schubbydoo/LED-Light-Bar/README.md

# LED Light Bar

A portable, battery-powered light bar whose ambience is driven by speech, so that a simulated
fire appears to speak the words of a greeting.

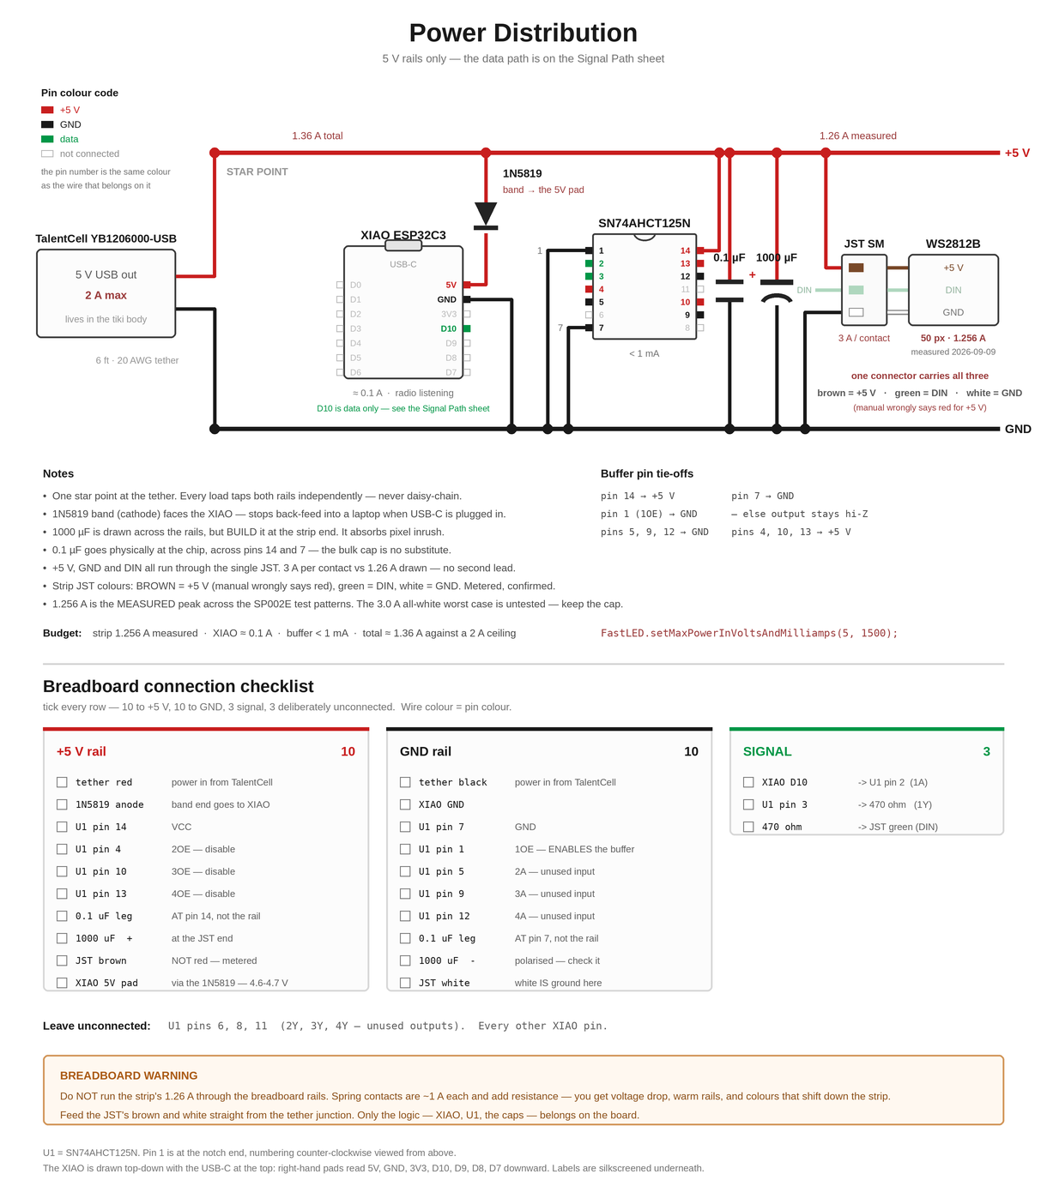
[picture p1: images/power-distribution.png]
Power distribution


## What it is

A ~1 m (3.2 ft) strip of **144** addressable pixels in a flexible diffuser, run by a XIAO
ESP32C3 on a battery. (It ran as a 14" section of 50 pixels in a rigid channel until 2026-09-12;
the count is the only thing that changed about the effect, and `docs/02-build-and-power.md`
carries what it did to the power budget.) **The length is a setting** — `len <inches>`, 1 to 144
— because the flexible diffuser contours to whatever prop the bar visits, so how much of the
strip is in use is a fact about the season rather than about the build. It renders a **named ambience** — `fire`, `water`, `storm` — continuously and
unsupervised. When the [SFX Box](#the-sfx-box) plays a greeting, the speech modulates that
ambience in time with the words.

For Halloween 2026 it is placed in the mouth of a borrowed tiki: firelight on the back of the
throat, and when a visitor triggers the prop, the fire speaks to them.

## Design in brief

**The box owns the speech; the bar owns the aesthetics.** The SFX Box sends an ambience name,
a pre-computed speech track, a cue at actual playback start, and a position update every couple
of seconds. It never sends colours. The bar excites its ambience with two scalars —
`excitation` and `onset` — which each ambience interprets in its own visual terms.

That separation is what makes the capability generic: the same two numbers drive a servo jaw on
another prop. See `sfx-box/spec-addendum-5.7A-speech-driven-channels.md`.

## Documentation

| | |
|---|---|
| [`docs/01-effect-design.md`](docs/01-effect-design.md) | The fire model, speech modulation, and the failure modes that make an LED strip look like an LED strip |
| [`docs/02-build-and-power.md`](docs/02-build-and-power.md) | Electrical ground truth — power, signal, both diagrams, strip specs, mechanical constraints |
| [`docs/03-perfboard-layout.md`](docs/03-perfboard-layout.md) | The electronics pod: layout rules, wiring list, staged assembly and test order |
| [`docs/04-rf-link.md`](docs/04-rf-link.md) | ESP-NOW: why not WiFi or 433, the SFX Box bridge wiring, and what crosses the link |
| [`docs/05-parts.md`](docs/05-parts.md) | What was bought and why |
| [`docs/archive/`](docs/archive/) | Superseded work, kept because the reasoning is still useful |

## Status

**Hardware verified and wired. Firmware not started.**

The strip was smoke-tested on its bundled SP002E controller: all 50 pixels light, and the power
path through the single JST is proven at **1.256 A measured**. Wire colours were metered to the
silkscreened pads, and the light-bar wiring was completed 2026-09-09.

That measurement was the 50-pixel run. Since **2026-09-12** the build lights all 144, and an
averaged USB meter reads **~1.0–1.2 A (~5.5 W)** with the fire at rest — about **55 %** of the
TalentCell's 2 A ceiling and **~9 h** of runtime. **During a greeting it drops to ~0.7–0.8 A**,
because the speech effect blacks the strip out between words, so a busy night costs less than a
quiet one. `./send.sh bar pwr` reports the firmware's own estimate, which agrees with the meter —
read the meter over time, since a breathing fire makes any single sample meaningless.

*This Status section otherwise predates the firmware, which is written and running on the prop —
`CLAUDE.md` is the current account.*

Nothing downstream of the XIAO's data pin has been exercised yet, since no code exists. Next
step is firmware — start from `docs/01-effect-design.md`, and make the first thing that runs a
single-pixel test rather than the fire renderer.

## The SFX Box

A separate, private project: a general-purpose Raspberry Pi effects controller that plays the
audio, watches the sensor, and drives this bar. It is **not vendored here**. `sfx-box/` contains
only the architectural proposal that project needs in order to host this capability.

## Licence

Personal project. No licence granted.
