schubbydoo/LED-Light-Bar/images/power-distribution-hand-drawn.png

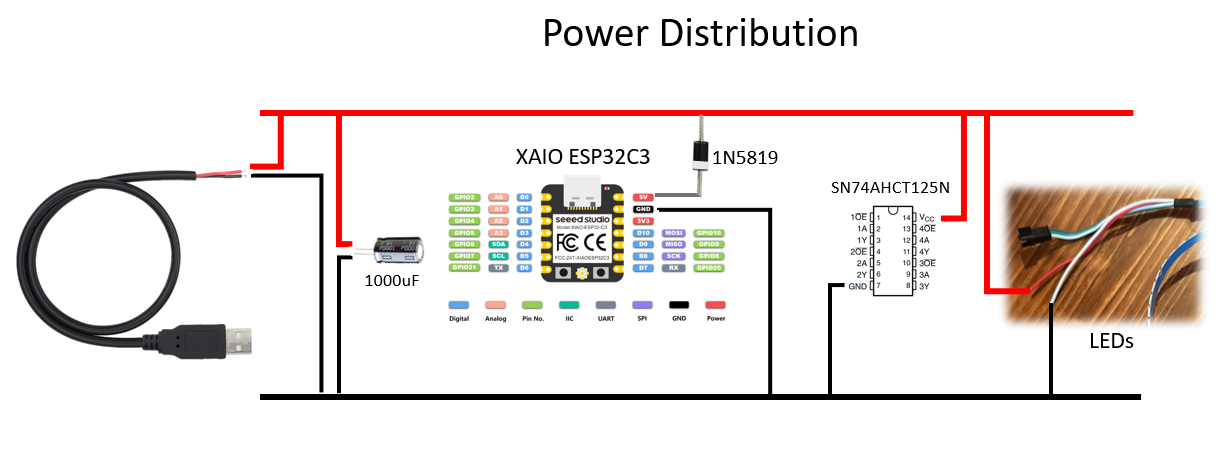
images/power-distribution-hand-drawn.png
