schubbydoo/LED-Light-Bar/images/parts/433-tx118sa-rx480e.jpeg

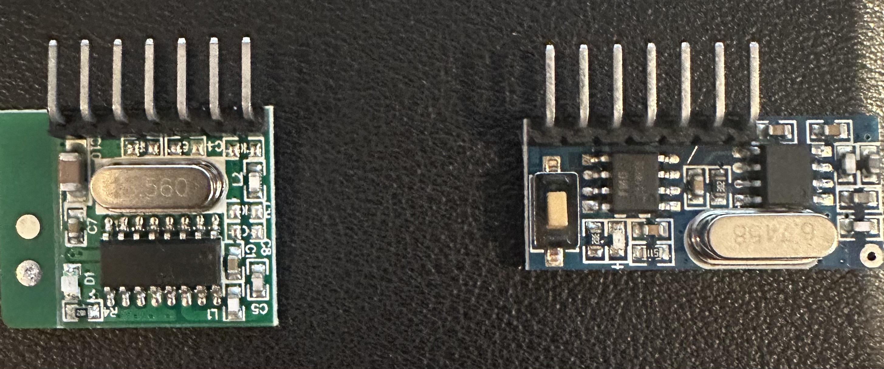
images/parts/433-tx118sa-rx480e.jpeg
