schubbydoo/LED-Light-Bar/images/parts/xiao-esp32c3.jpeg

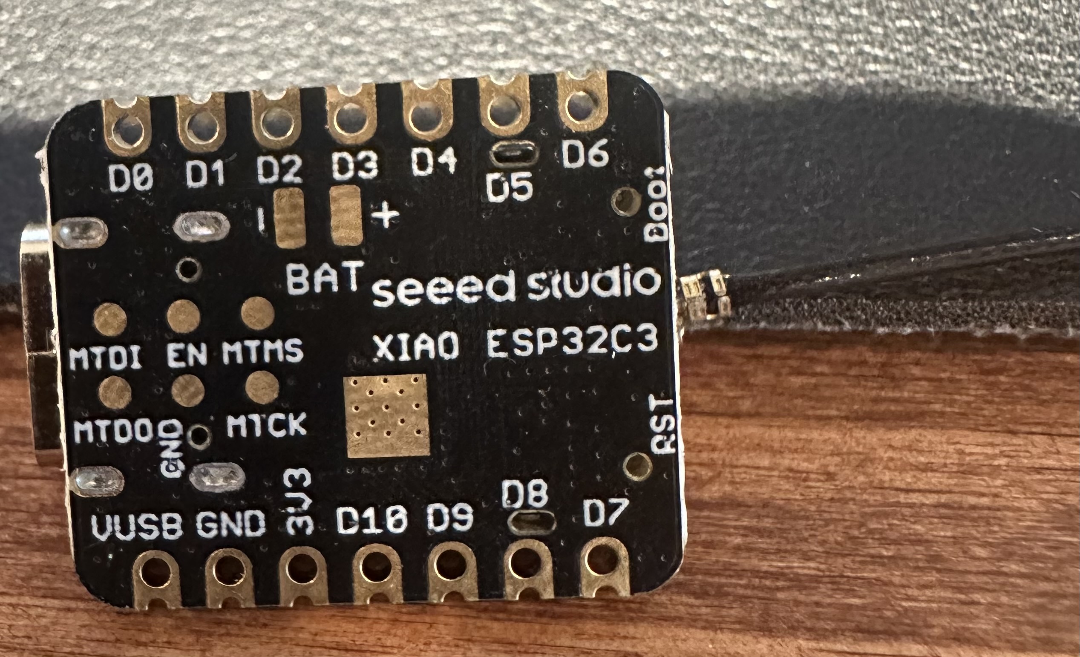
images/parts/xiao-esp32c3.jpeg
