schubbydoo/LED-Light-Bar/(commit log)

2026-09-09 Initial commit: LED Light Bar design, wiring and SFX Box addendum
    Speech-driven light bar: 50 WS2812B pixels on a XIAO ESP32C3, battery
    powered, driven over ESP-NOW by the SFX Box so a simulated fire appears
    to speak the words of a greeting.
    Hardware is verified (SP002E smoke test, 1.256 A measured) and the
    light-bar wiring is complete. No firmware exists yet.
    Contents:
    - docs/01..05 - effect design, power and signal, perfboard layout,
    the ESP-NOW link, and parts
    - images/ - power distribution, signal path and SFX Box bridge sheets;
    every pin colour-coded by function, XIAO drawn as a top view
    - sfx-box/ - the 5.7A spec addendum the SFX Box project needs; the
    SFX Box repo itself is de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
2026-09-10 Say what the box provides, and where the firmware lives
    Two things settled with the SFX Box side today.
    The box now generates and serves word timestamps — GET /media/timestamps/<id>,
    one shape whichever provider answered, with a version field for a bar that
    cached a track. That is the discrete half of the two-axis model, not the fire's
    driver: word boundaries make a fire strobe rather than burn, and the envelope
    this project actually wants is still unbuilt on that side. What timestamps give
    us is the other half the addendum asks for — phrase structure, so the bar can
    visibly settle between phrases and flare harder on an emphasised word.
    Three entry types occur in a real track, checked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
2026-09-10 Firmware bring-up: prove the chain before the strip is at risk
    No code had ever run on this board. The strip was smoke-tested on its bundled
    SP002E controller, so the pixels and the power path are known good — what has
    never been exercised is our own signal path: D10, the AHCT125, the 470R, the JST.
    Two sketches, in the order the risk demands.
    `metercheck` runs with the strip disconnected. It holds D10 at steady DC long
    enough to read with an ordinary multimeter — a meter cannot follow a 400 ns
    WS2812 bit, and averaging a data stream gives a meaningless number between the
    rails. Probe U1 pin 2 and pin 3: pin 3 at ~5 V while pin 2 sits at 3.3 V proves
    the entire level-shifter stage in o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
2026-09-10 The diode is a 1N5819 — say so once, everywhere
    The build offered either a 1N5817 or a 1N5819 and then two documents each picked
    a different one. `docs/03` named the 5817 in its parts table, its zone map and
    both rows of its wiring list; the diagrams and the checklist named the 5819.
    The board has a 5819. Confirmed against the part, 2026-09-10.
    No number changes, which is why this went unnoticed: every figure in the repo
    already assumed the 5819's higher drop. The XIAO's 5 V pad is documented as
    4.6-4.7 V rather than 5.0, and that reading is how you confirm the diode is
    oriented correctly rather than a sign of a sagging rail.
    Found while reviewing the sheets before the strip was connect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
2026-09-10 The fire: four layers, one expression, no talking mode
    `bar/` implements docs/01's model — ember floor, whole-strip breath, correlated
    spatial noise, Poisson flares — with colour a pure function of heat and gamma
    applied last. 458 kB, 34 % of flash.
    The structural decision is the whole design:
    heat[i] = clamp(EMBER_FLOOR,
    (noise[i] + flare[i]) * breath * (1 + speechGain*env),
    1.0)
    At env == 0 that collapses exactly to the idle fire. So there is no talking
    mode, no crossfade, and no state to get wrong — idle is speech with a zero
    envelope. Written this way on purpose: a prop that switches to a "speaking"
    animation stops being a fire that sp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
    [bar.ino, pixelcheck.ino]
2026-09-10 Fire palette: orange body, amber sparks, and a live warmth knob
    Two rounds of feedback against a real strip. First pass came out red, second
    came out yellow; this is the middle, and it is not signed off — it was judged
    against a white wall, which docs/01 §2 names as the surface that will mislead
    you. Recorded so the numbers are not lost, not because they are final.
    The red one had a mechanical cause worth keeping. Per-channel gamma on a palette
    authored as PWM values crushes it:
    (200, 50, 0) "orange" --gamma 2.2--> (149, 7, 0) near-pure red
    (255,110,10) "flame" --gamma 2.2--> (255, 40, 0) deep red-orange
    (255,190,80) "tip" --gamma 2.2--> (255,133,20) merely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
2026-09-10 The link: text over ESP-NOW, and the bar answers back
    The bridge forwards serial lines verbatim and the bar feeds them into the SAME
    parser its own serial port uses, so every command it already understood worked
    over the radio the moment this existed. No second protocol, no second parser to
    drift. Proven end to end:
    ./send.sh bridge "set yellow 0.75"
    ./send.sh bridge "set brightness 90"
    ./send.sh bridge st
    bar> st amb=fire y=0.75 br=90 breath=1.10 rel=0.080 gain=1.20 env=0.00
    Text rather than a binary struct at this stage: the wire is readable, so a
    mismatch between the ends is visible instead of a silent misalignment, and the
    link can be exercised by hand before anythin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
    [bar.ino, bridge.ino]
2026-09-10 The fire speaks: resident track, and a clock that is not ours
    bar> cue ok 1 at 13000 lead -40
    env=0.92 trk=2067 playing@19160
    env=0.77 trk=2067 playing@25206
    env=0.48 trk=2067 playing@32222
    The Tiki greeting's envelope, generated on the Pi, pushed over ESP-NOW, and
    stepped against the box's clock.
    The track is RESIDENT before playback starts and is never streamed. 2 bytes per
    frame at 50 Hz is 100 B/s, so 41 s is 4.1 kB — 28 chunks in one burst at
    provisioning time. During the performance the link carries a cue, a position
    update every couple of seconds, and nothing else, which means packet loss during
    a greeting is not a failure mode that exists.
    THE CLOCK IS THE BOX'S.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
    [bar.ino, bridge.ino]
2026-09-10 Words, not loudness — and a fire that was rendering in a third of its range
    audio bar drift env
    2.83 2.87 +48ms 0.00 drums: fire idle
    10.76 10.78 +21ms 0.00
    14.76 14.73 -22ms 0.26 first word at 13.6s
    18.71 18.75 +40ms 1.00 mid-word
    22.64 22.67 +33ms 0.29 between words
    38.51 38.50 -11ms 1.00
    Sync holds to +/-55ms across 40 seconds with no accumulation — the errors wander
    around zero rather than growing, which is the cue carrying real playback position
    plus `pos` easing it. Spec success criterion is ~50ms; met on the first measured
    run.
    THE IDLE FIRE WAS BROKEN, and it was underneath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
    [bar.ino, bridge.ino]
2026-09-10 The approved effect: red words over a breathing fire
    Signed off on the prop. Compiled defaults are now the values that were actually
    judged, not the ones I guessed:
    flashHue 0 red
    flash 0.6 the flame shows THROUGH the speech colour
    blackout 0.6 fire dims to 40% between words, not fully out
    0.6 rather than 0.9 on the mix because at 0.9 the speech colour nearly replaces
    the fire and reads as a separate light switching on. At 0.6 the bright parts of
    the flame come through warmer than the dim parts, so the strip keeps its own life
    while a word is lit — "the fire goes red", not "a red light turns on".
    0.6 rather than 1.0 on the blackout because full darkness left th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
    [bar.ino]
2026-09-11 The fire stops teleporting: accumulate the noise phase
    A noise coordinate must be an ACCUMULATED PHASE, never `time * rate`.
    This read:
    uint16_t tz = (uint16_t)(tSec * P.timeScale * (1.0f + 0.6f * env));
    which multiplies ABSOLUTE time by a rate that speech is modulating. The
    instant `env` moves, the product jumps — thirty seconds in, env going
    0.4 to 0.9 shifts tz by over a THOUSAND noise units. The pattern does not
    speed up, it teleports. Against a real speech envelope moving several
    times a second the whole strip scrubs back and forth, and what you see is
    rapid blinking. `noisePhase += dt * timeScale` is the whole fix, and
    speech now genuinely accelerates the drift with no disconti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
    [bar.ino]
2026-09-11 The track survives a power cycle
    This stopped being a field-reliability nicety today and became the thing
    that actively broke a day of testing: the track lived only in RAM, so
    every firmware reflash emptied it, and three consecutive greetings played
    to a silently dark bar while looking exactly like the effect being broken.
    In the field a battery blip would do the same, mid-evening, with nobody
    able to explain it.
    Two stores, because the two kinds of state want opposite things.
    PARAMS -> NVS, and only on an explicit `save`. Auto-saving on every `set`
    would write flash on every nudge of a tuning slider, and tuning is dozens
    of nudges. Explicit also matches how a look is actually arrived at: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
    [bar.ino]
2026-09-11 Write down how persistence works, and what it changed about verification
    The commit that built it landed without the doc update — the anchor I
    patched against did not exist. Content is the same: two stores with
    opposite needs, params as a versioned-and-sized blob rather than a key per
    parameter, and why `st` had to start reporting the clip the moment a
    track could outlive a reboot.
2026-09-11 A lamp: a chosen colour, solid or blinking or breathing
    A prop does not always want speech. Sometimes it wants a red light that
    comes on, or a blue one that breathes.
    That is not a second renderer, and it must not become one. A LAMP IS AN
    AMBIENCE WHOSE PALETTE RAMPS FROM BLACK TO A CHOSEN COLOUR, so at heat 0
    it is off and at heat 1 it is the colour — which means "solid" and
    "breathing" fall straight out of the layers that already exist and only
    blinking is new. `motion` decides what feeds heat and nothing after that
    changes: a lamp goes through the same palette lookup, the same speech
    excitation, the same word colour and the same blackout as a fire does. A
    blinking red lamp that also sp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
2026-09-11 Hold the top of the palette instead of wrapping to black
    `ColorFromPalette` with LINEARBLEND treats a 16-entry palette as a RING:
    at index 255 it blends entry 15 back toward entry 0 and returns 15/16 of
    entry 0 — which in every palette here is BLACK. Heat clamps to 1.0, so
    heat 1.0 rendered as almost nothing.
    Found because `motion solid` pins heat at exactly 1.0, and the strip went
    dark: reported as "the light bar is not on anymore". The battery had also
    died, which explains the strip being unlit — but the XIAO runs off the
    box's USB and kept answering, and it reported `heat=1.00 px=62,10,2`. That
    is arithmetic, not a power symptom.
    The fire had the same fault, silently. Peak heat happ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
2026-09-12 The whole strip, and a length you can set
    Two changes that only make sense together. The bar now lights all 144 pixels
    of the metre rather than a 14" cut of 50 — and because the new diffuser is
    flexible rather than a rigid channel, how much of that metre is in use became
    a property of the season instead of the build.
    NUM_LEDS is gone. MAX_LEDS (144) sizes the buffers and is the only part that
    is still a recompile; P.numLeds is live, persisted and settable over the
    radio as `set leds <n>` or `len <inches>`. The tail beyond it is written black
    every frame, not once, because FastLED clocks the whole buffer either way and
    a tail painted once would freeze the last image on it. The FastLED cont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
2026-09-12 Measured, not calculated: the cap does not bite and the draw is half what we said
    Flashed the 144-pixel build to the bar and then asked it what it actually
    draws. Both answers contradict the arithmetic committed this morning.
    A USB meter on the supply reads 5.05 V / ~0.80 A — about 4 W for the whole
    build, XIAO included, against a predicted ~1.5 A. The prediction came from the
    manual's 0.12 W/LED scaled by brightness, and that is the figure for WHITE.
    This fire is amber and red at partial heat and never goes white, so the real
    number is a little over half of it. Runtime follows: ~13 h, not ~6.5 h, so the
    "margin is one night rather than two" warning was pessimistic by 2x.
    The cap therefo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
2026-09-12 A length of zero is a typo, not a request
    The bar went dark except for pixel 0 showing amber, on a prop that had been
    working. That is not a failure mode — it is the renderer doing exactly as it
    was told with numLeds=1: the fire renders into pixel 0 and the tail blackout
    takes the other 143.
    Arduino's String::toFloat() answers 0.0 for anything it cannot parse. So
    `len abc`, `len` with a stray character, `set leds 0` and `set leds` with junk
    all arrive as zero, and the clamp I wrote turned every one of them into one
    pixel. A typo wearing the costume of a dead strip is the worst possible
    disguise: it sends you to the wiring, the power rail and the level shifter
    before it occurs to you that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
    [bar.ino]
2026-09-12 The reel's density is a setting, not a constant
    `len` converted against a hard-coded 144 LED/m, which is right only for the
    strip that happens to be fitted. Addressable strip is sold by LEDs per metre —
    30, 60, 74, 96, 144 are all standard — so on a 60/m reel `len 24` built a
    10-inch bar, and the reply reported 39" for a strip that was really 94" long.
    Wrong by 2.4x, with nothing anywhere saying so.
    `ledsPerM` joins Params (PARAMS_VERSION 4 -> 5), is reported in `st` as `perM=`
    and in the boot banner, and is what `len` and the banner now divide by. Range is
    generous rather than a menu: 74/m is a real product and a firmware that refused
    an unfamiliar number would be wrong more often than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
    [bar.ino]
2026-09-12 The cap bites for whole-strip modes, not for the fire
    Real measurements from the prop, and they correct this morning's correction.
    This file has now claimed the cap "will bite", then "never bites"; neither was
    right, and the difference is which pixels a mode lights at once.
    The approved fire never reaches it: 887-1185 mA across 14 samples with
    `allowed` equal to `brightness` every time. That is the look a greeting
    performs, so the effect the prop actually does is never held down.
    But `motion breathe` samples 1400-1489 mA with `capped=1` on about half, and a
    solid white lamp is pinned at the cap outright. Those modes drive every pixel
    to full TOGETHER; the fire only ever drives some of them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
    [bar.ino]
2026-09-30 The bridge was running flat out to forward a few lines a minute
    loop() had no delay, and the Arduino core's loop task outranks the idle
    task, so the CPU never idled and the board ran warm around the clock. Yield
    1 ms per pass, and drop the clock to 80 MHz; it only shuttles text. Radio
    TX power and channel are untouched, so link range does not change.
    Flashed to the bridge on the prop; `st` over the air still answers.
