schubbydoo/LED-Light-Bar/images/parts/strip-manual-page1.jpeg

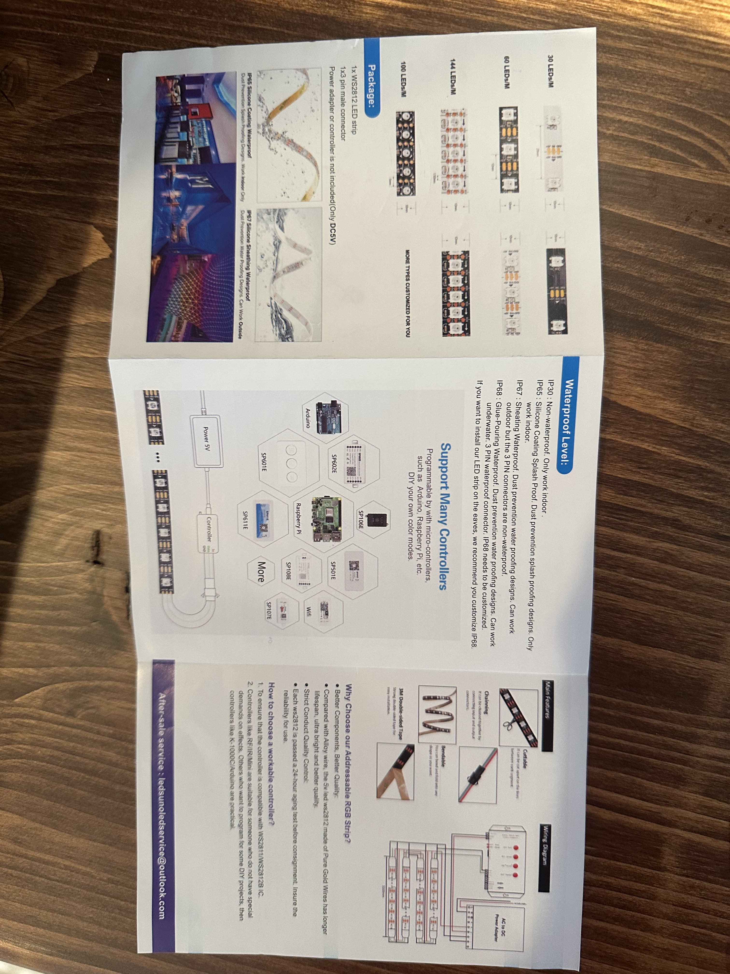
images/parts/strip-manual-page1.jpeg
