schubbydoo/LED-Light-Bar/images/parts/strip-manual-page2.jpeg

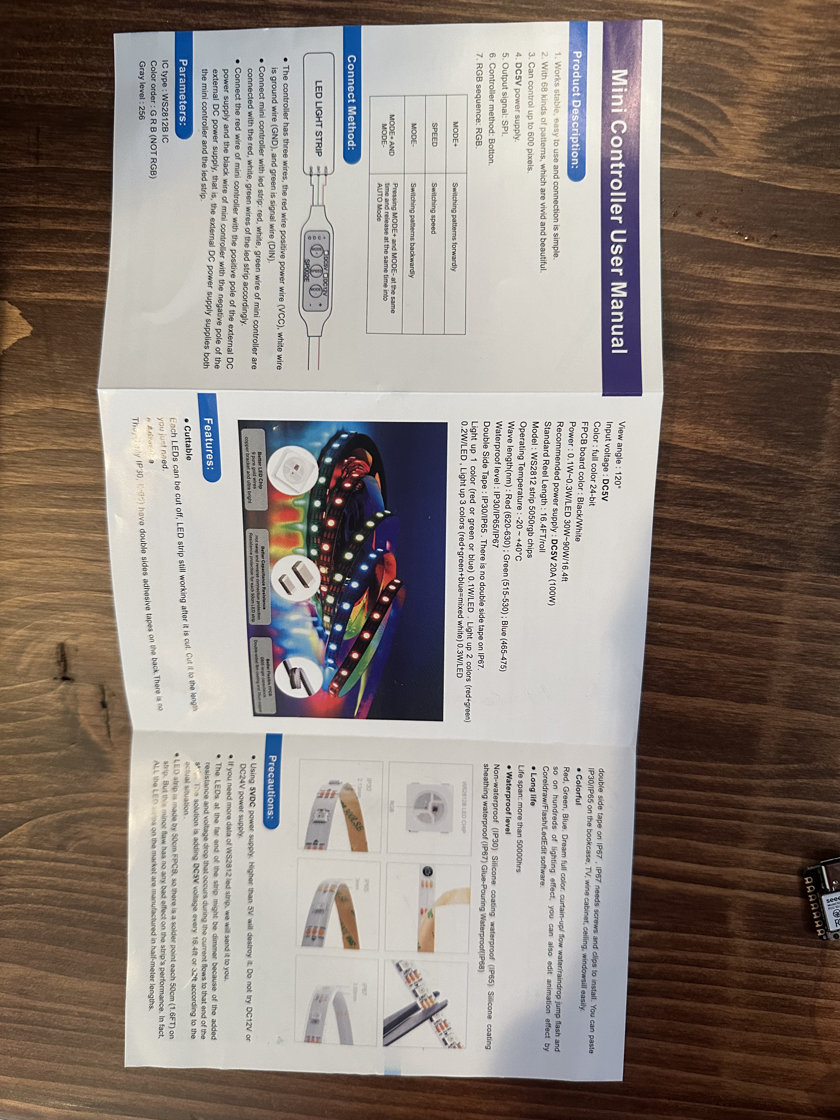
images/parts/strip-manual-page2.jpeg
