schubbydoo/LED-Light-Bar/images/parts/led-strip-and-xiao.jpeg

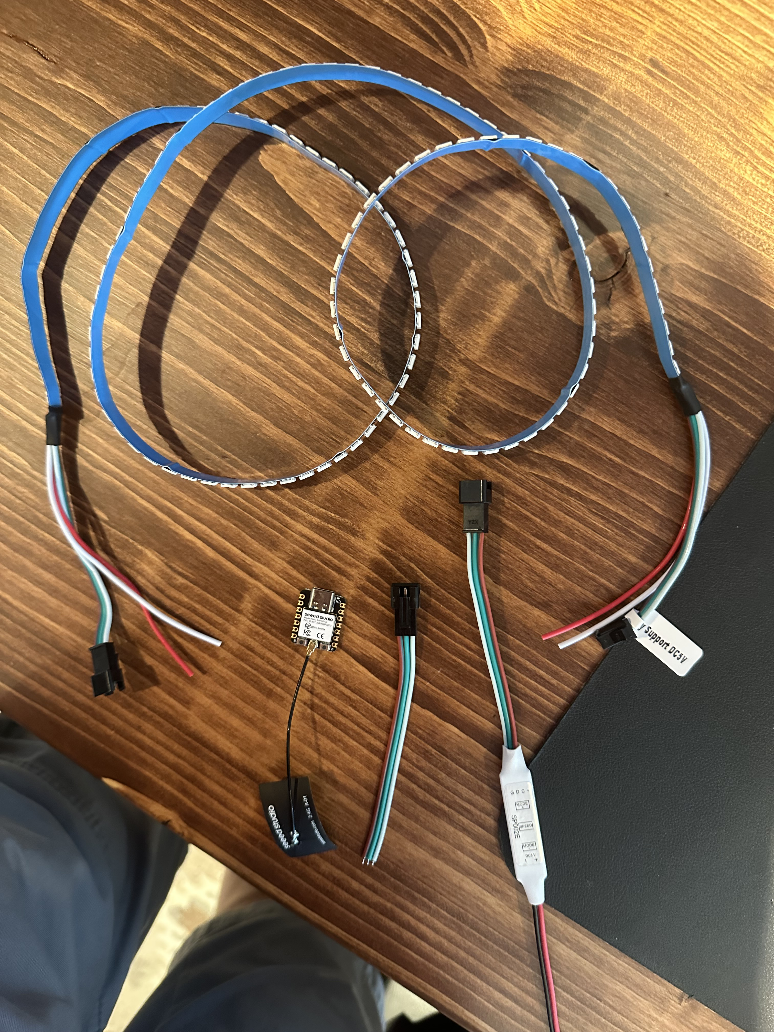
images/parts/led-strip-and-xiao.jpeg
